avdeevsv91/acebox_v1x/Media/h_1436699458_7142652_b5be4882d7.jpg

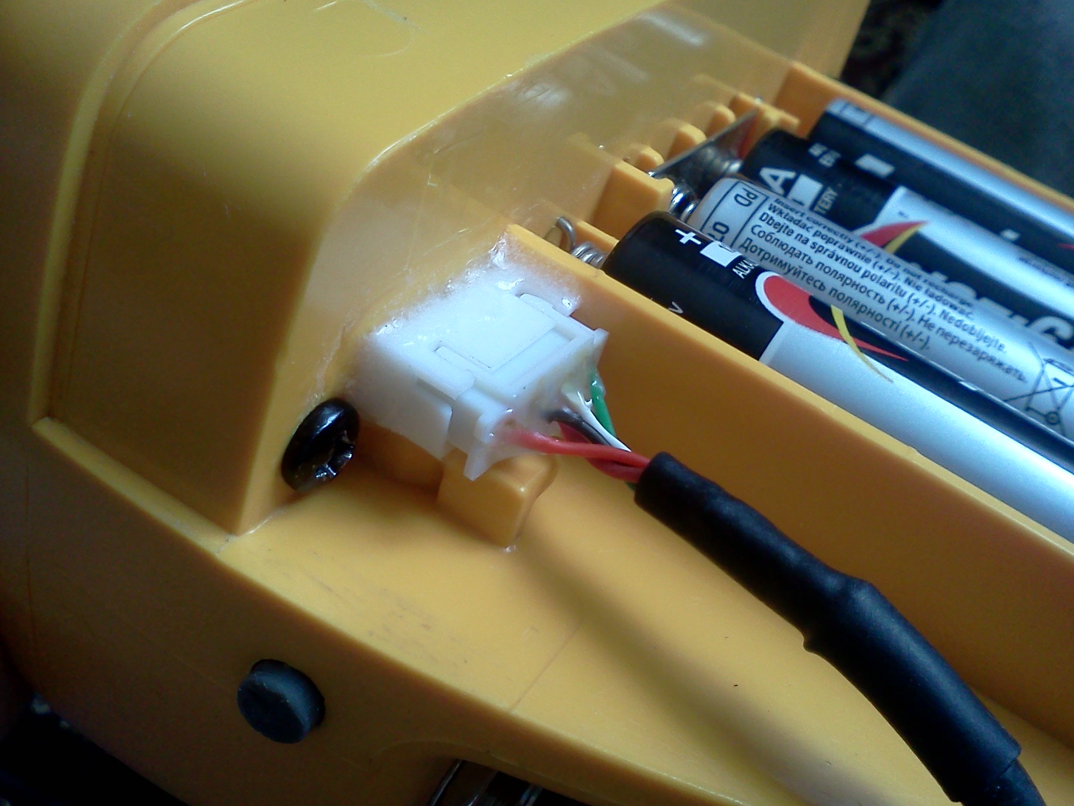
Media/h_1436699458_7142652_b5be4882d7.jpg
