avdeevsv91/acebox_v1x/Media/h_1436700264_7776511_fd009b2079.jpg

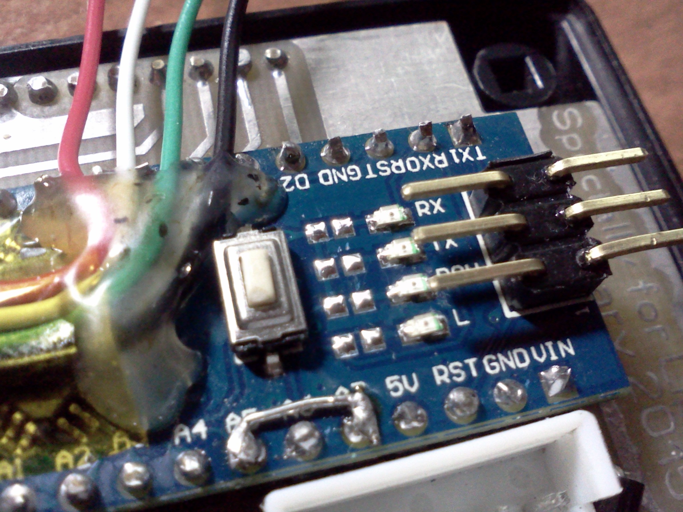
Media/h_1436700264_7776511_fd009b2079.jpg
