avdeevsv91/acebox_v1x/Media/h_1423683731_7540186_cf0576831e.jpg

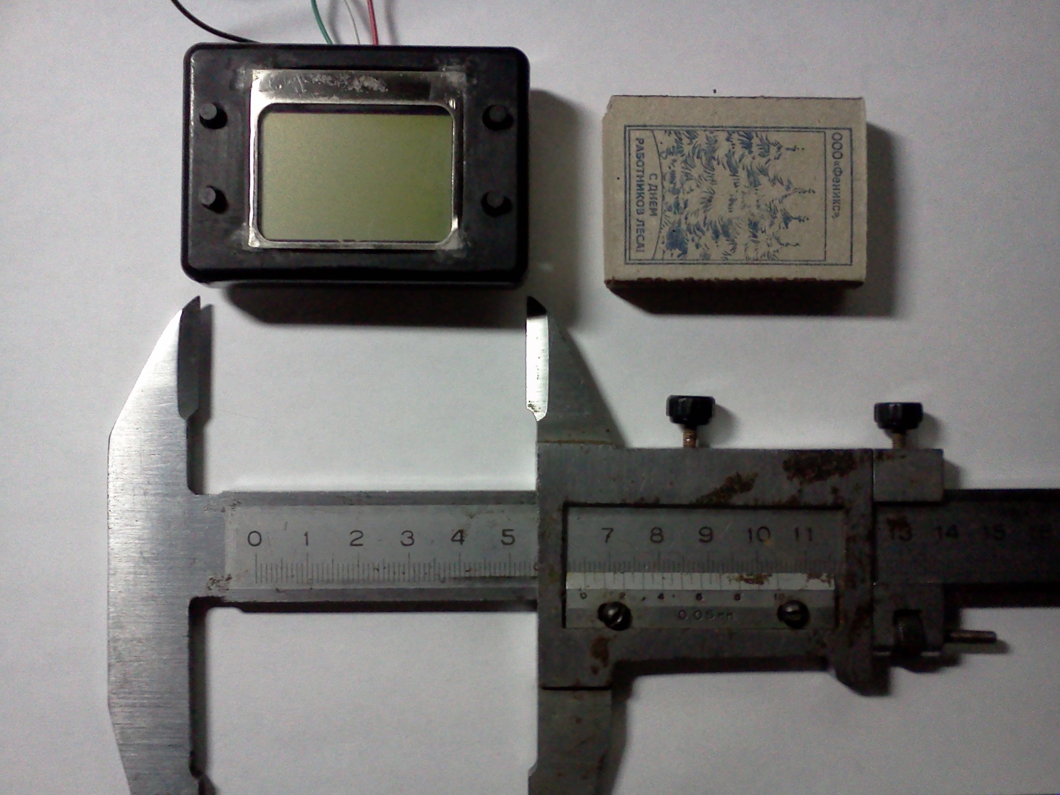
Media/h_1423683731_7540186_cf0576831e.jpg
