avdeevsv91/acebox_v1x/Media/h_1423754609_3159344_025f83f39f.jpg

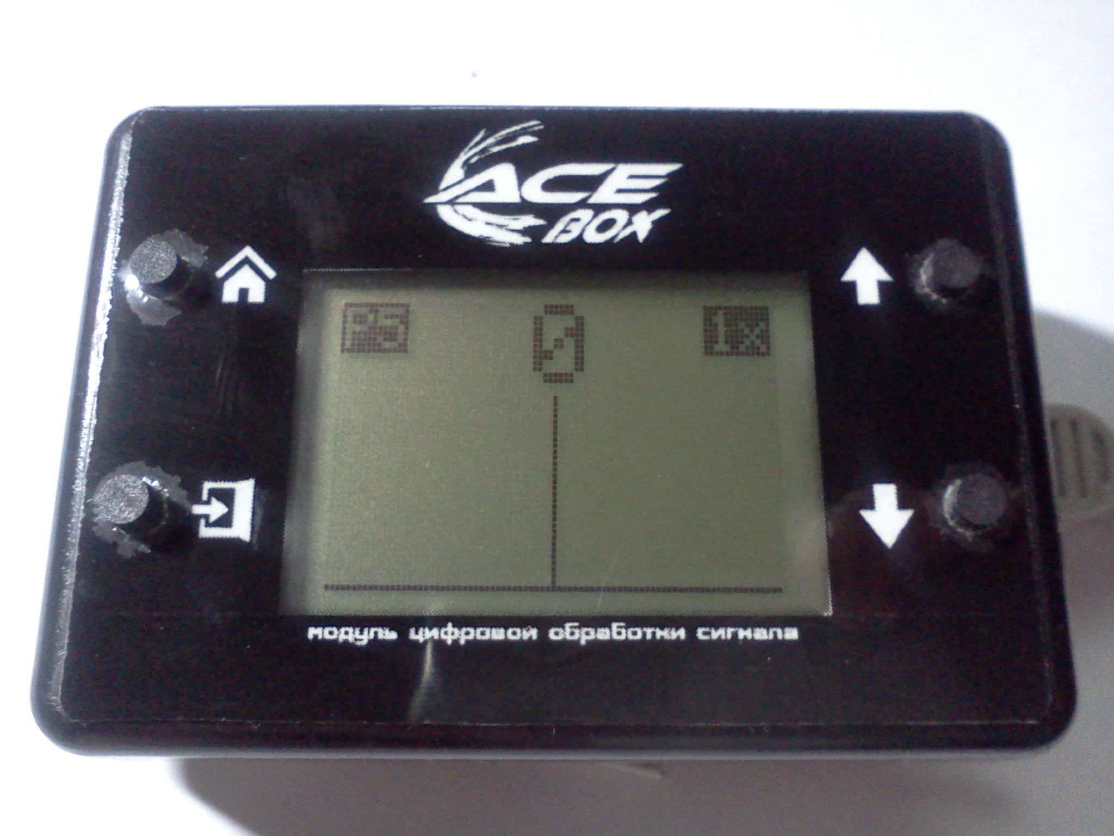
Media/h_1423754609_3159344_025f83f39f.jpg
