avdeevsv91/acebox_v1x/Media/h_1424028475_1767077_f4e5950bf5.jpg

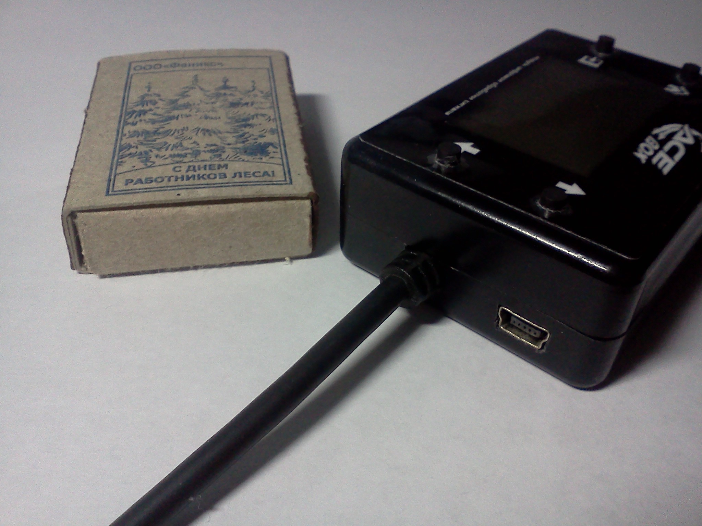
Media/h_1424028475_1767077_f4e5950bf5.jpg
