avdeevsv91/acebox_v1x/Media/h_1424028475_8953906_7fa5a69045.jpg

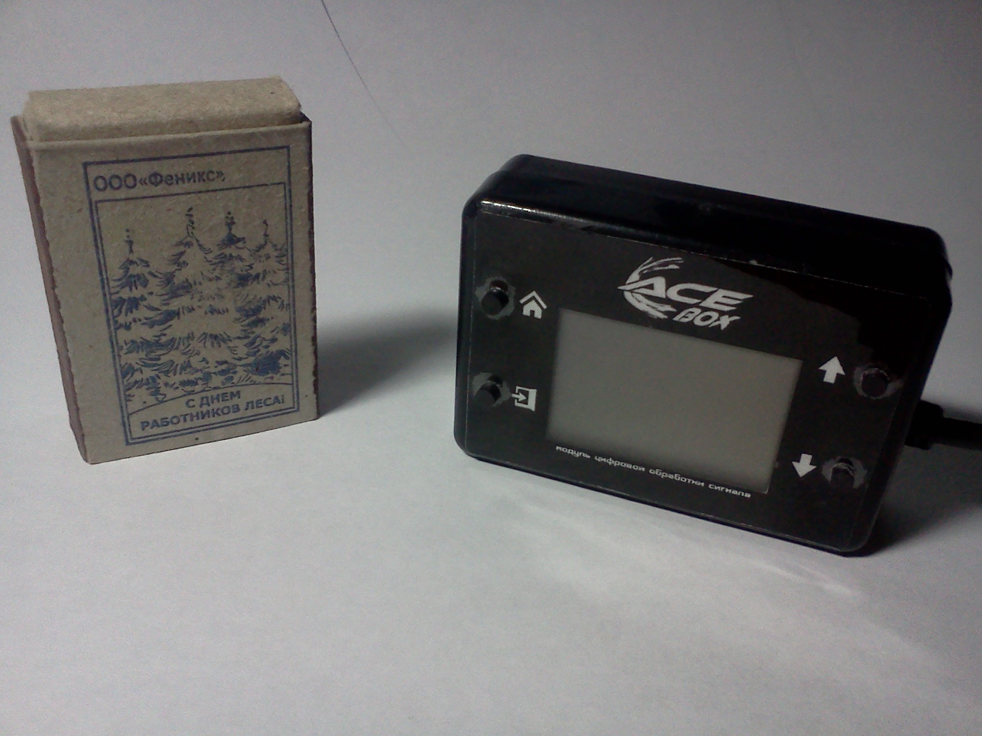
Media/h_1424028475_8953906_7fa5a69045.jpg
