avdeevsv91/acebox_v1x/Media/h_1424028482_1395577_e4022bb532.jpg

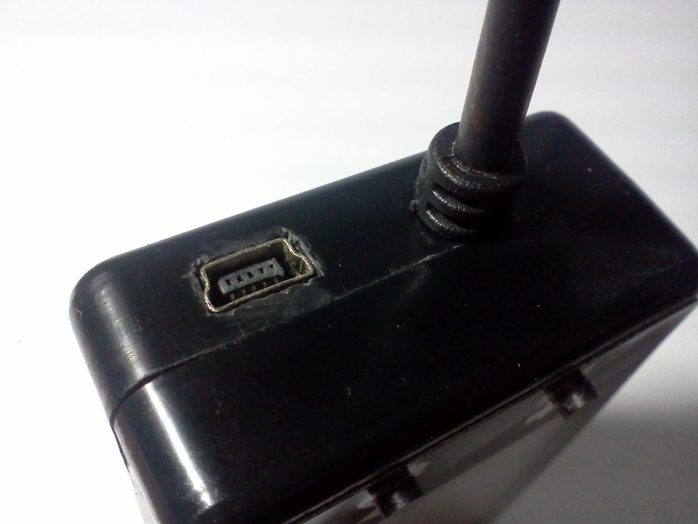
Media/h_1424028482_1395577_e4022bb532.jpg
