avdeevsv91/acebox_v1x/Media/h_1424028482_1836966_f15030745e.jpg

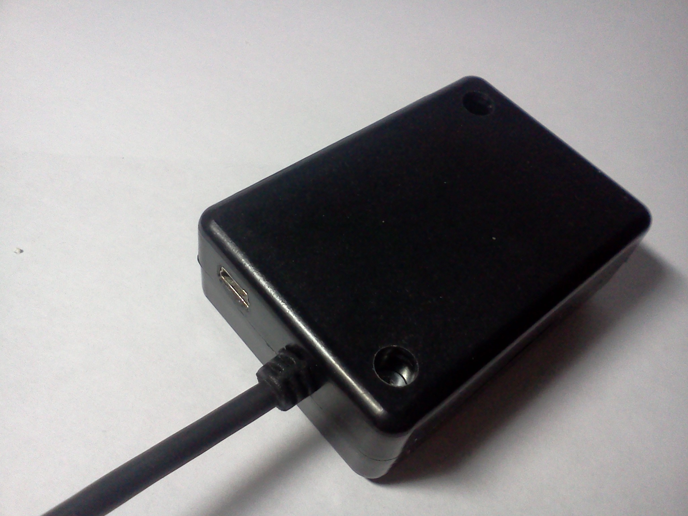
Media/h_1424028482_1836966_f15030745e.jpg
