avdeevsv91/acebox_v1x/Media/h_1424028488_4101360_d6cb5d2832.jpg

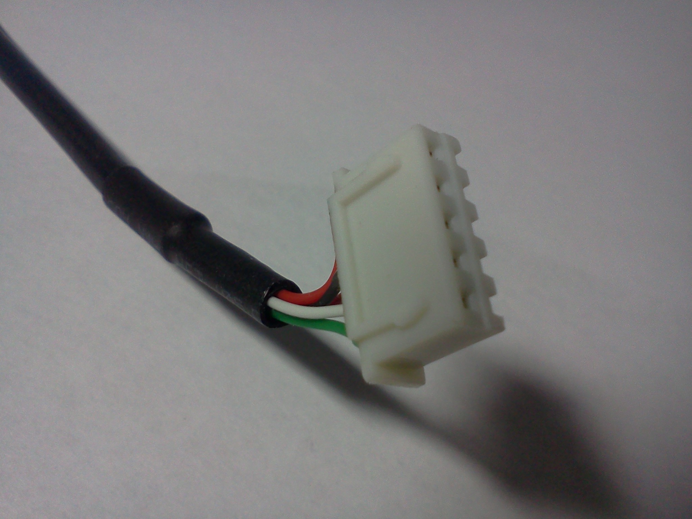
Media/h_1424028488_4101360_d6cb5d2832.jpg
