avdeevsv91/acebox_v1x/Media/h_1424028489_1070069_ecf3d33940.jpg

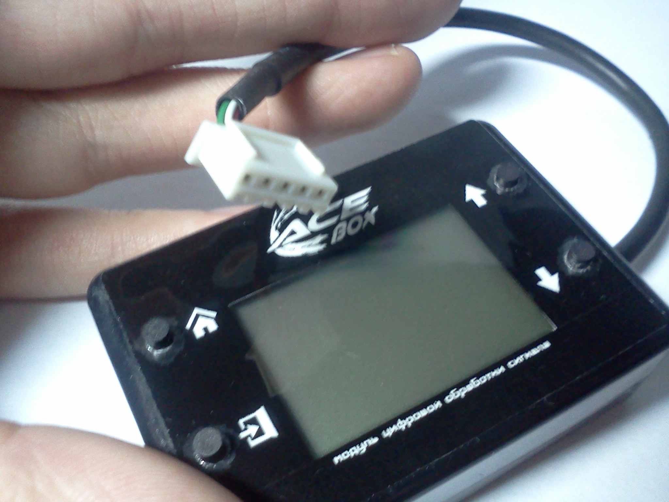
Media/h_1424028489_1070069_ecf3d33940.jpg
