avdeevsv91/acebox_v1x/Media/h_1436699310_1320474_925bd0f9bd.gif

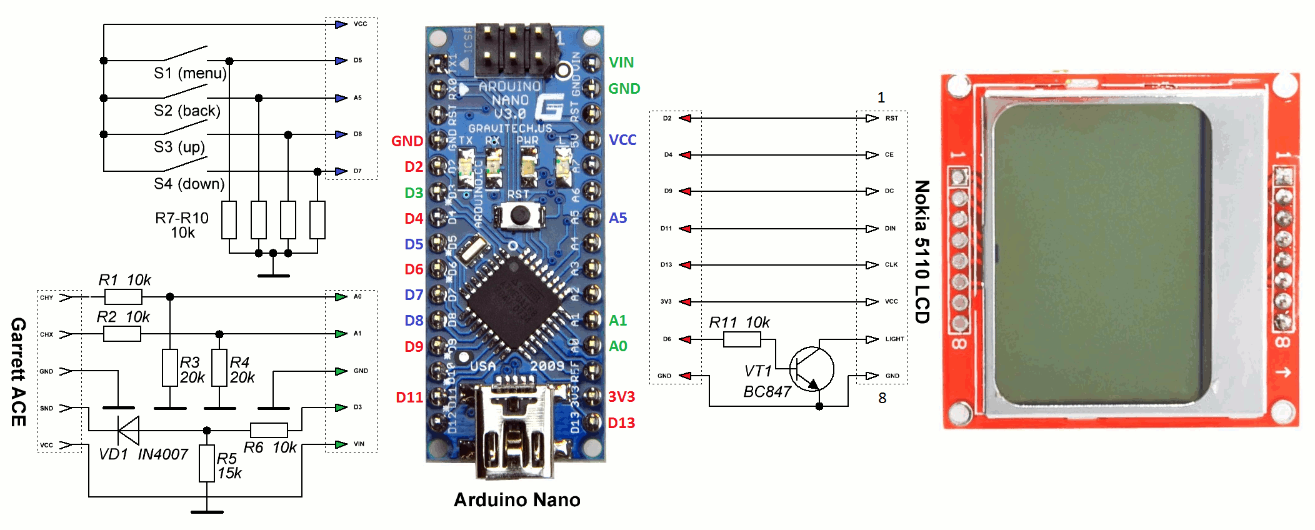
Media/h_1436699310_1320474_925bd0f9bd.gif
