avdeevsv91/acebox_v1x/Media/h_1436699315_4549355_43847fd801.jpg

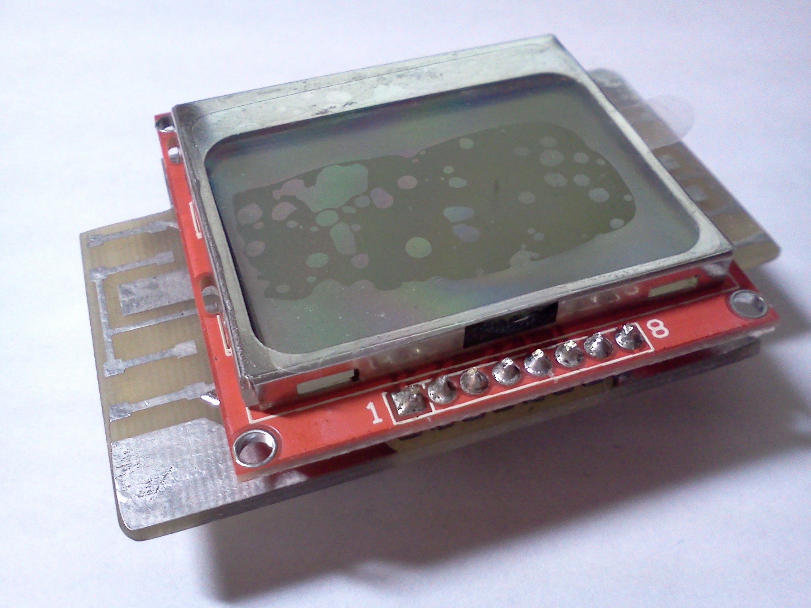
Media/h_1436699315_4549355_43847fd801.jpg
