avdeevsv91/acebox_v1x/Media/h_1436699332_2136066_18a5c41815.jpg

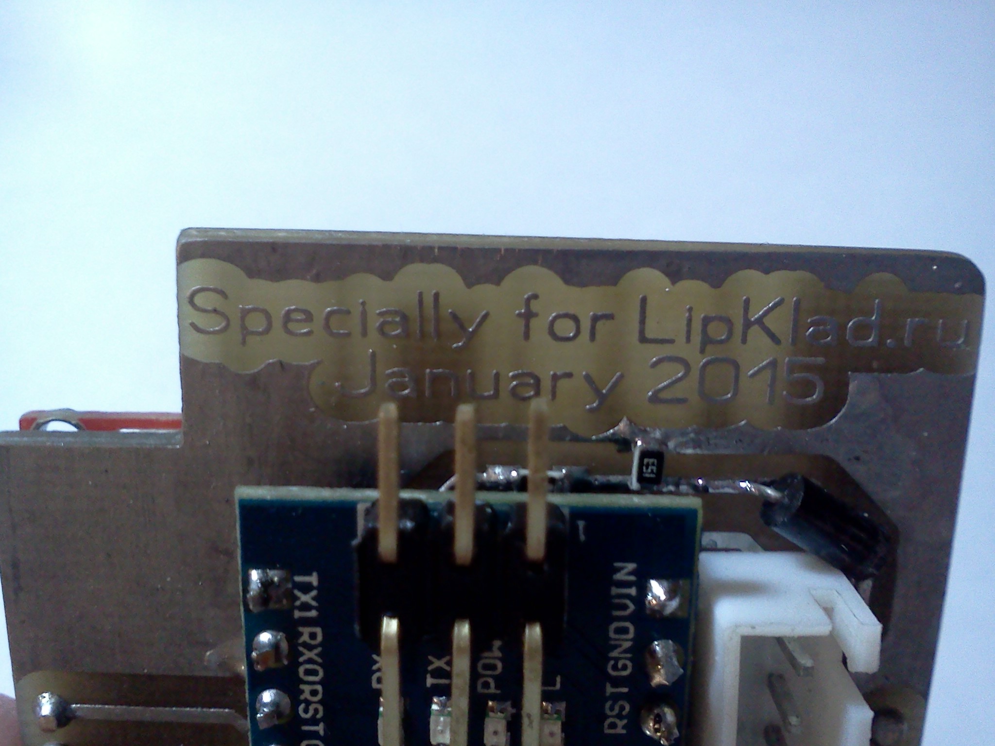
Media/h_1436699332_2136066_18a5c41815.jpg
