avdeevsv91/acebox_v1x/Media/h_1436699349_6175307_7a8917141e.jpg

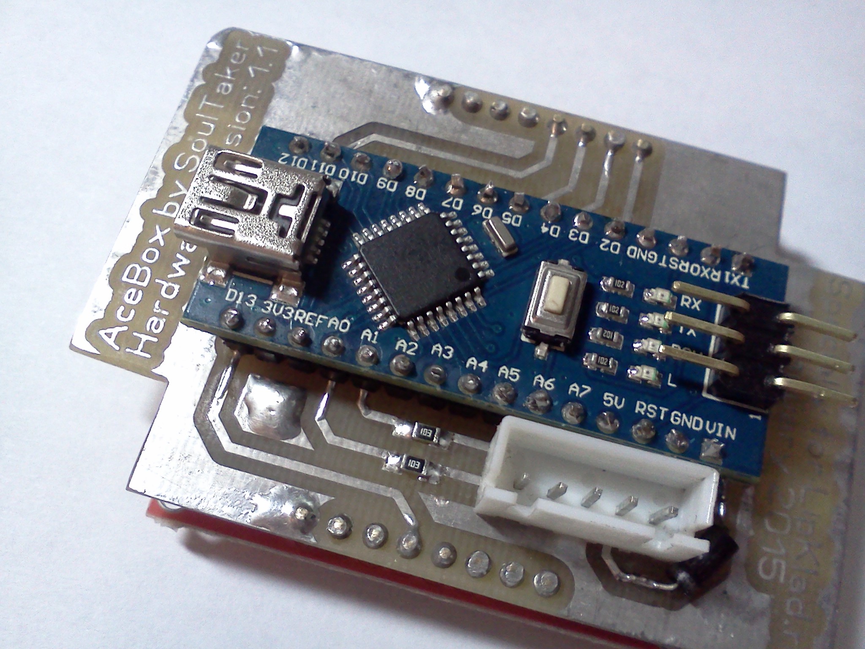
Media/h_1436699349_6175307_7a8917141e.jpg
