avdeevsv91/acebox_v1x/Media/h_1436699390_7895153_b987f142b3.jpg

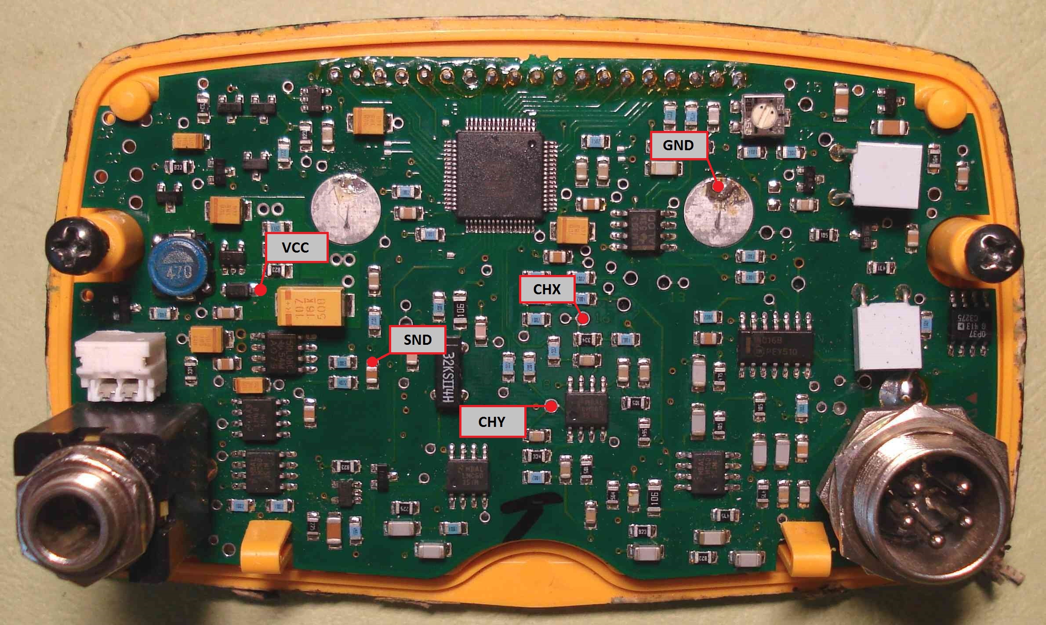
Media/h_1436699390_7895153_b987f142b3.jpg
