avdeevsv91/acebox_v1x/Media/h_1436699428_8460501_0f78375653.jpg

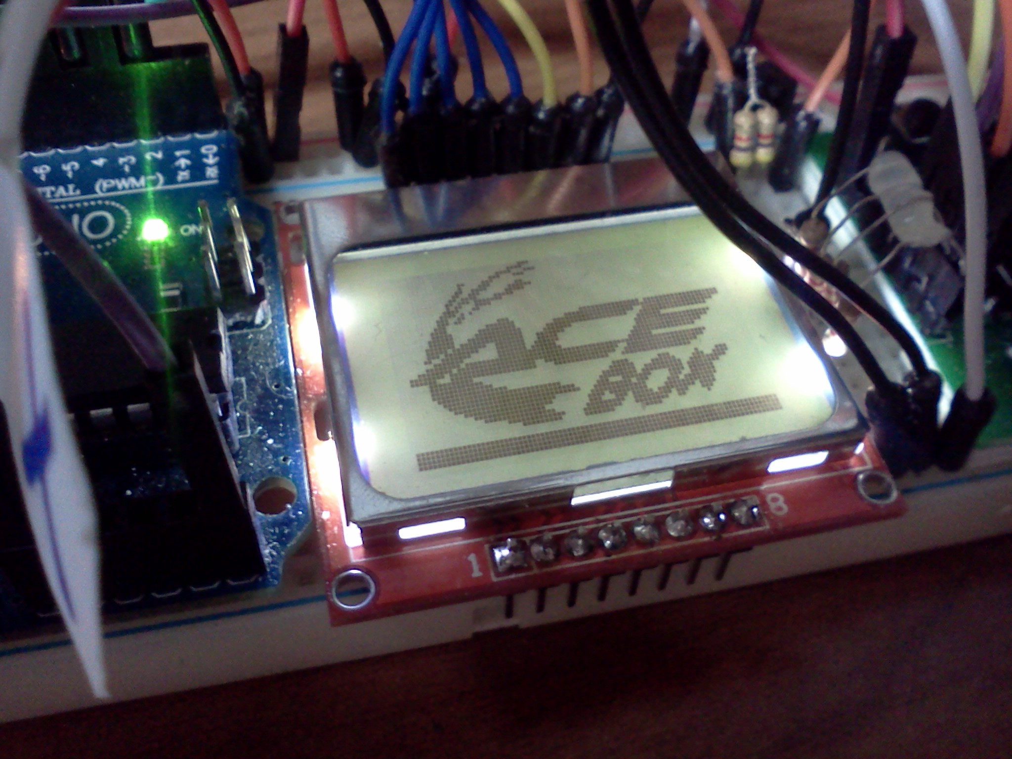
Media/h_1436699428_8460501_0f78375653.jpg
