avdeevsv91/acebox_v1x/Media/h_1436699441_5028405_5e4dd1117b.jpg

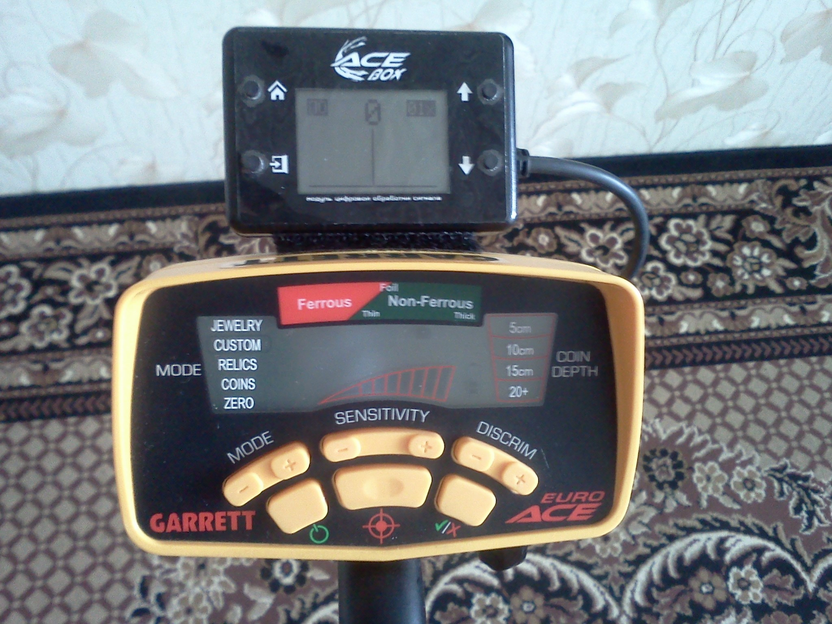
Media/h_1436699441_5028405_5e4dd1117b.jpg
