avdeevsv91/acebox_v1x/Media/h_1436699455_7861674_1967207178.jpg

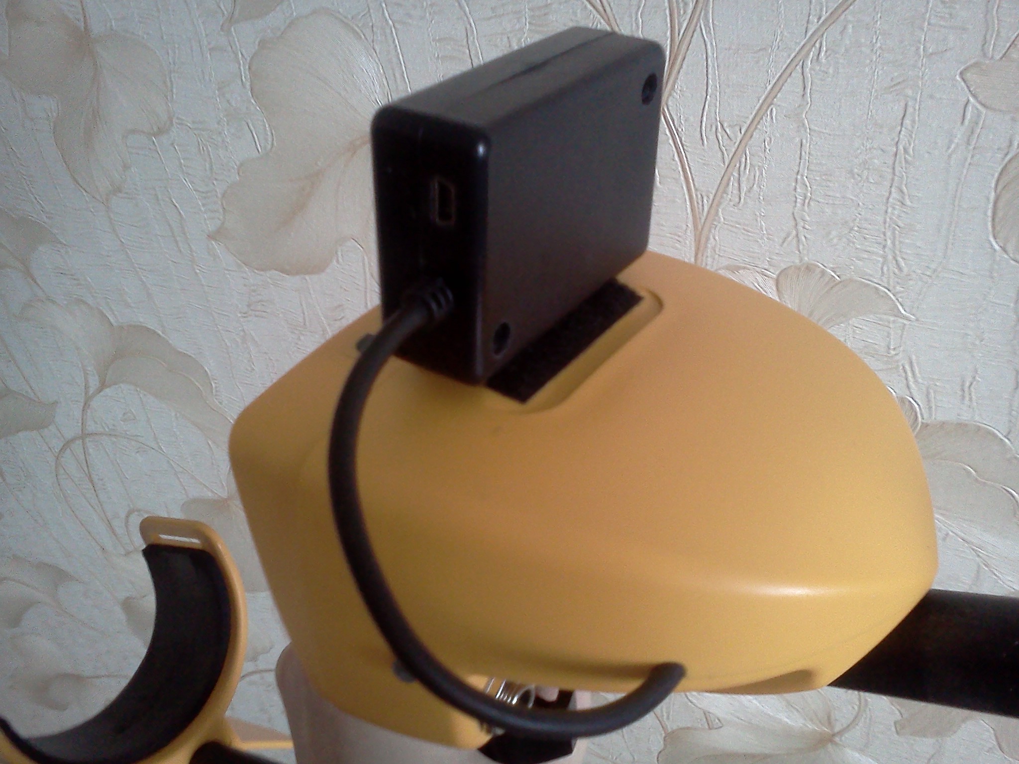
Media/h_1436699455_7861674_1967207178.jpg
