avdeevsv91/acebox_v1x/(list of files, drawings)

Other design files:
ace_box_v1.2_pcb.lay6
