avdeevsv91/acebox_v1x/c_project/images.h

#ifndef ACEBOXLOGO_H
#define ACEBOXLOGO_H

#ifdef __AVR__
 #include <avr/io.h>
 #include <avr/pgmspace.h>
#else
 #define PROGMEM
#endif

// AceBox logo picture
static const unsigned char acebox_logo[] PROGMEM = {
0X00,0X00,0X00,0X00,0X1C,0X00,0X00,0X00,0X00,0X00,0X0C,0X00,0X00,0X00,0X00,0XF0,
0X00,0X00,0X00,0X00,0X00,0X07,0X00,0X00,0X00,0X07,0X8E,0X00,0X00,0X00,0X00,0X00,
0X01,0X00,0X00,0X00,0X1C,0X70,0X00,0X00,0X00,0X00,0X00,0X01,0X00,0X00,0X18,0X70,
0X00,0X00,0X00,0X00,0X00,0X00,0X03,0X00,0X00,0X10,0XE0,0X60,0X00,0X00,0X00,0X00,
0X00,0X0C,0X00,0X00,0X33,0XC1,0XF8,0X00,0X00,0X00,0X00,0X00,0X01,0X00,0X00,0X67,
0X03,0XE0,0X00,0X00,0X00,0X00,0X00,0X0E,0X00,0X00,0XDE,0X1F,0X00,0X00,0X00,0X00,
0X00,0X00,0X05,0X00,0X01,0XBB,0XF8,0X00,0X00,0X00,0X00,0X00,0X00,0X01,0X00,0X01,
0X63,0XC0,0X00,0X00,0X00,0X00,0X00,0X00,0X0D,0X00,0X03,0XC6,0X00,0X00,0X00,0X00,
0X00,0X00,0X00,0X03,0X00,0X07,0XA8,0X00,0X00,0X00,0X00,0X00,0X00,0X00,0X05,0X00,
0X0E,0X60,0X00,0X00,0X00,0X00,0X00,0X00,0X00,0X0B,0X00,0X0E,0XC0,0X00,0X00,0X00,
0X00,0X00,0X00,0X00,0X0A,0X00,0X1C,0X00,0X38,0X00,0X03,0XFF,0XFB,0XFF,0XFF,0X89,
0X00,0X3C,0X01,0XFC,0X00,0X3F,0XFF,0XFF,0XFF,0XFF,0X8E,0X00,0X3E,0X07,0XFC,0X01,
0XFF,0XFF,0XE7,0XFF,0XFE,0X08,0X00,0X7E,0X0F,0XFE,0X07,0XFF,0XFF,0X8F,0XFF,0XF8,
0X0E,0X00,0X7E,0X3F,0XFE,0X0F,0XE0,0X00,0X1F,0X80,0X00,0X05,0X00,0XFE,0XFF,0XFE,
0X3F,0X80,0X00,0X3F,0XFF,0XF8,0X04,0X00,0XFB,0XFC,0XFE,0X3E,0X00,0X00,0X3F,0XFF,
0XF0,0X0F,0X00,0XEF,0XF0,0XFE,0X7E,0X00,0X00,0X7F,0XFF,0XC0,0X03,0X01,0X9F,0XC0,
0XFE,0XFC,0X00,0X00,0XFF,0XFF,0X00,0X03,0X00,0X7F,0X00,0XFF,0XFE,0X00,0X01,0XF8,
0X00,0X00,0X05,0X01,0XFE,0XFF,0XFF,0XFF,0XFF,0XFF,0XFF,0XFF,0XC0,0X04,0X07,0XFB,
0XFF,0XFF,0XFF,0XFF,0XF3,0XFF,0XFF,0X80,0X0C,0X1F,0XEF,0XFF,0XFF,0X3F,0XFF,0XE7,
0XFF,0XFE,0X00,0X0D,0X1F,0X8F,0XFF,0XFF,0X0F,0XFF,0X8F,0XFF,0XF8,0X00,0X0F,0X01,
0XFF,0X80,0X00,0X00,0X00,0X00,0X00,0X00,0X00,0X06,0X01,0XFF,0XE0,0X00,0X00,0X00,
0X78,0X0E,0X04,0X38,0X03,0X01,0XFF,0XF8,0X00,0X00,0X00,0XFC,0X3F,0X0E,0X78,0X0F,
0X01,0XFF,0XFF,0X00,0X00,0X03,0XFC,0XFF,0X9F,0XF0,0X0D,0X00,0XFF,0XFF,0XFF,0XF0,
0X07,0XFD,0XFF,0XBF,0XC0,0X0C,0X00,0X7F,0XFF,0XFF,0XFE,0X0E,0X3F,0X87,0XBF,0X00,
0X0A,0X00,0X3F,0XFF,0XFF,0XFF,0X1F,0XF7,0X07,0X3F,0X00,0X0A,0X00,0X1F,0XFF,0XFF,
0XC0,0X3F,0XFE,0X0E,0XFF,0X00,0X09,0X00,0X07,0XFF,0XFF,0X80,0X7B,0XFE,0X1F,0XFE,
0X00,0X0D,0X00,0X01,0XFF,0XFE,0X00,0X71,0XDF,0X7F,0XDE,0X00,0X03,0X00,0X00,0X7F,
0XFF,0X80,0XFF,0X9F,0XF7,0X1C,0X00,0X07,0X00,0X00,0X03,0XFF,0XE1,0XFF,0X1F,0XE6,
0X08,0X00,0X02,0X00,0X00,0X00,0X7F,0XC1,0XFC,0X0F,0X80,0X00,0X00,0X0C,0X00,0X00,
0X00,0X00,0X00,0X00,0X00,0X00,0X00,0X00,0X0D,0X00,0X00,0X00,0X00,0X00,0X00,0X00,
0X00,0X00,0X00,0X0D,0X7F,0XFF,0XFF,0XFF,0XFF,0XFF,0XFF,0XFF,0XFF,0XFF,0XE4,0X40,
0X00,0X00,0X00,0X00,0X00,0X00,0X00,0X00,0X00,0X24,0X40,0X00,0X00,0X00,0X00,0X00,
0X00,0X00,0X00,0X00,0X2E,0X7F,0XFF,0XFF,0XFF,0XFF,0XFF,0XFF,0XFF,0XFF,0XFF,0XE3,
};

#endif // ACEBOXLOGO_H
