avdeevsv91/acebox_v1x/(commit log)

2016-03-08 Added printed circuit board (Sprint Layout 6.0)
    [ace_box_v1.2_pcb.lay6]
2016-03-08 Added source code for Arduino IDE
